er-hariprasadadhikari/Four-Switch-Synchronous-Buck-Boost-Converter/images/buck proteus 6 v.jpg

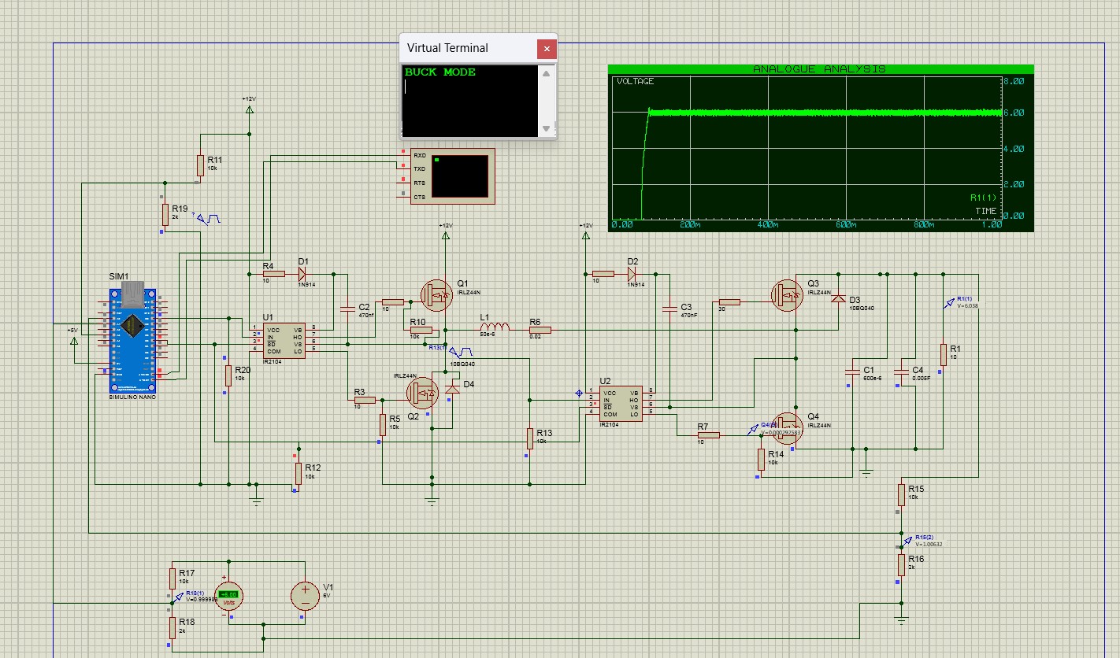
images/buck proteus 6 v.jpg
