er-hariprasadadhikari/Four-Switch-Synchronous-Buck-Boost-Converter/Hardware/final circuit.pdf

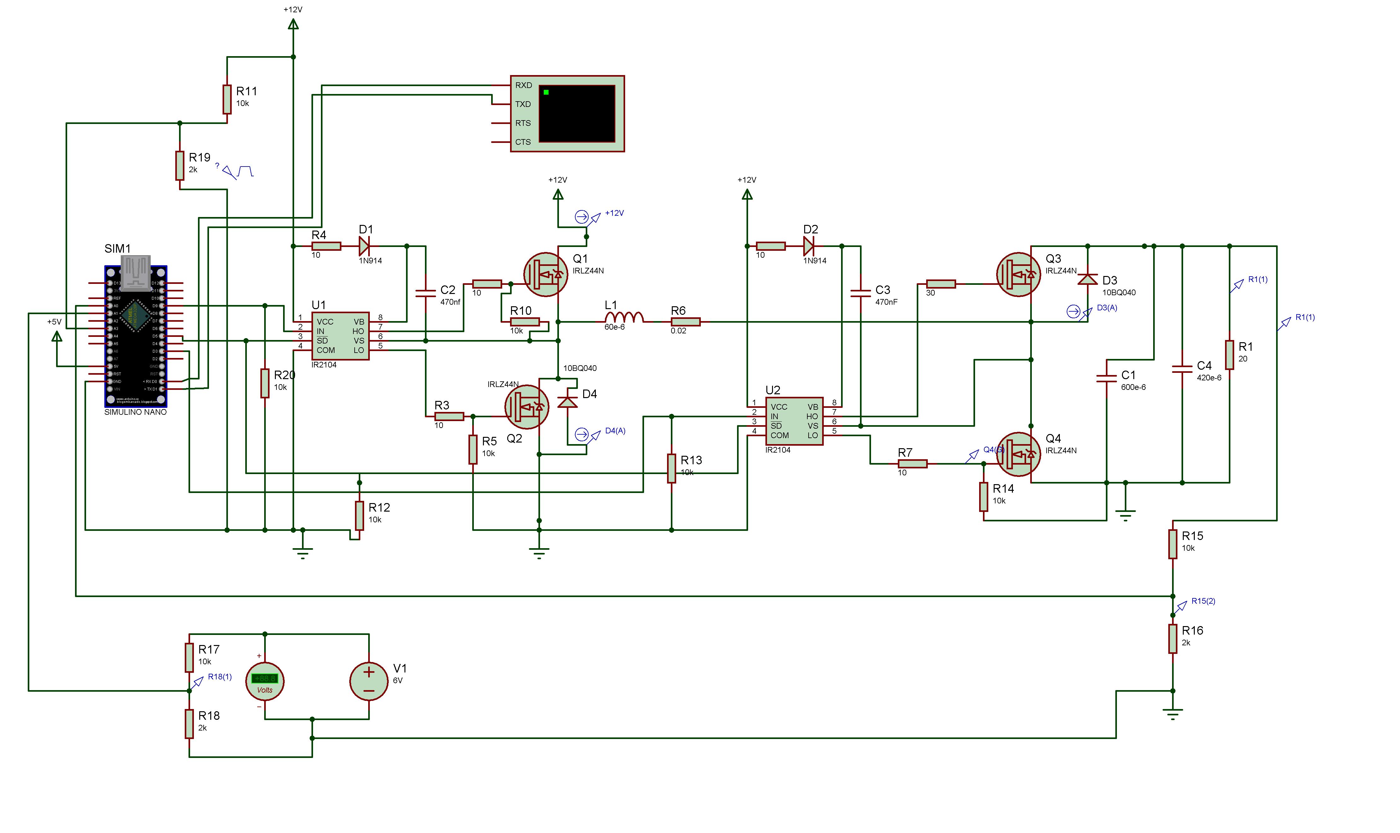
[picture p31: page 1]
