er-hariprasadadhikari/Four-Switch-Synchronous-Buck-Boost-Converter/images/boost with plot.jpg

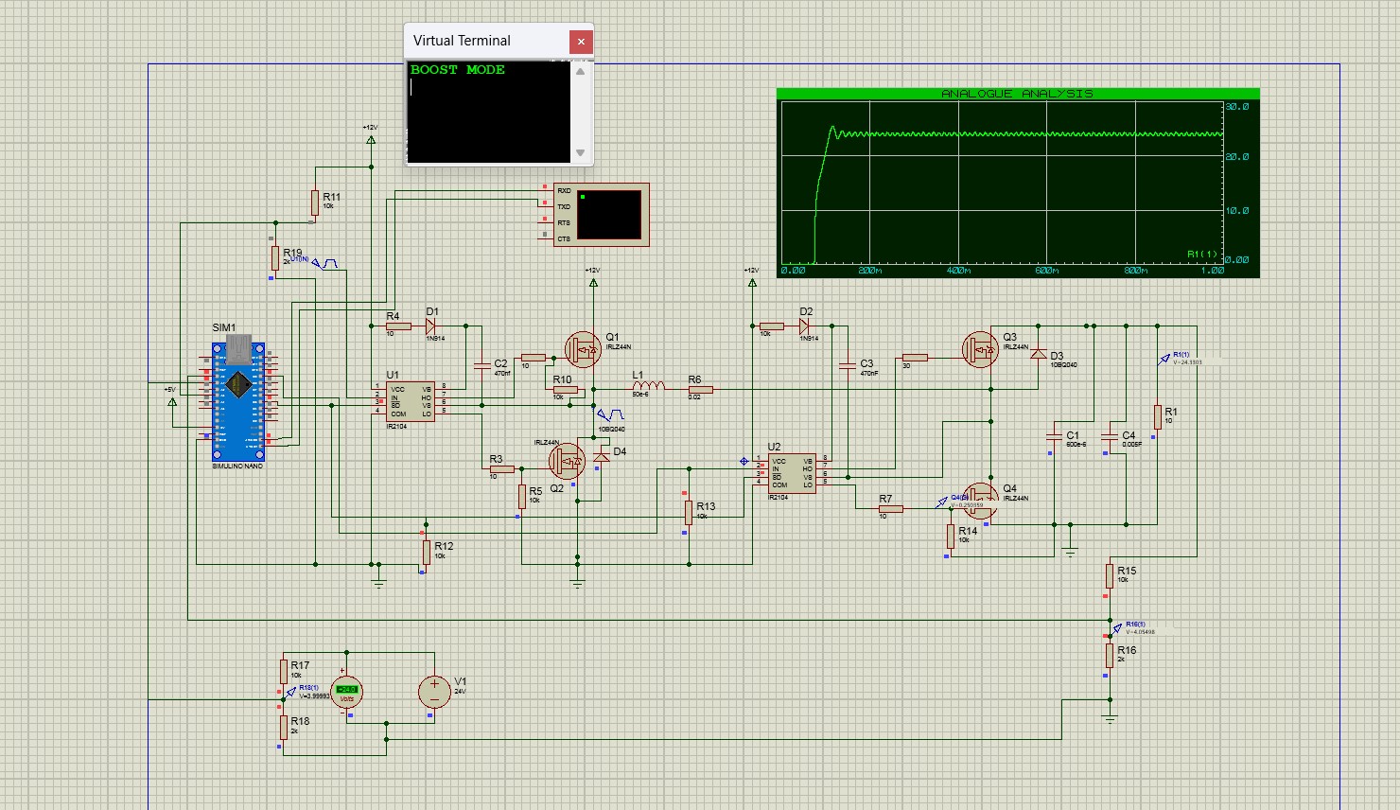
images/boost with plot.jpg
