er-hariprasadadhikari/Four-Switch-Synchronous-Buck-Boost-Converter/images/final block.jpg

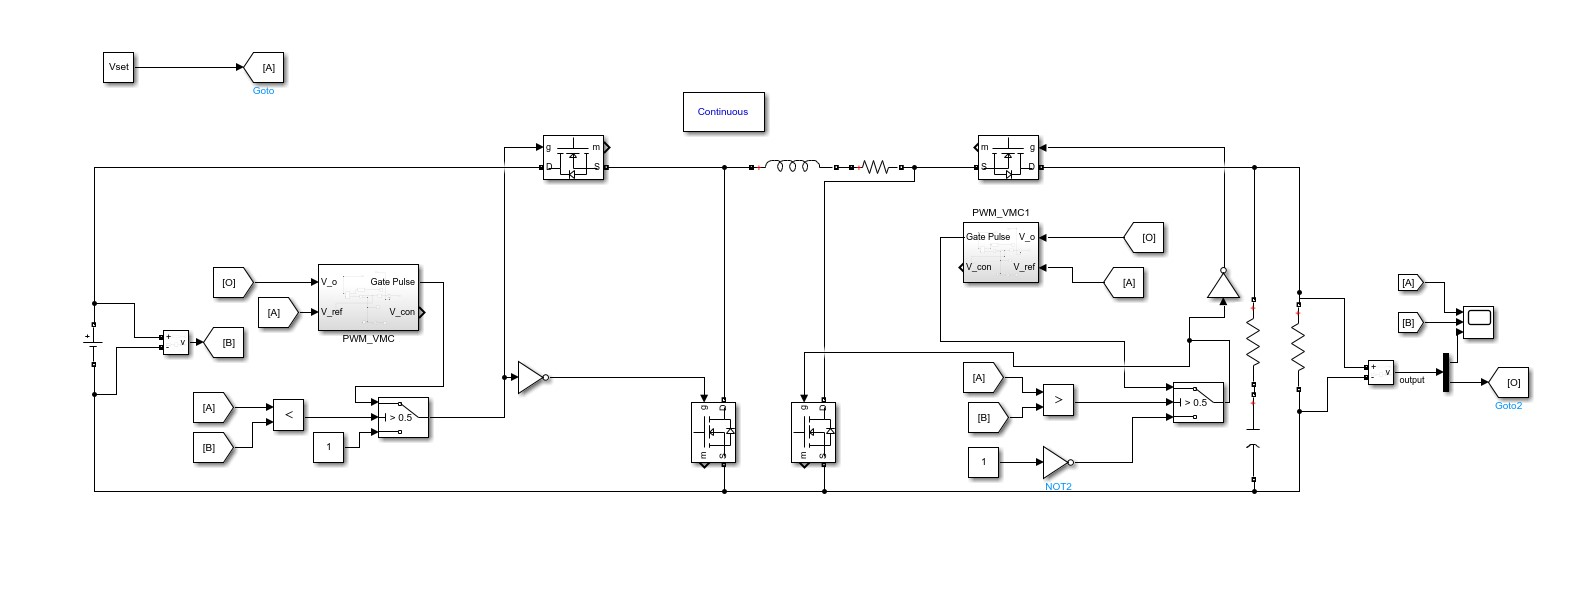
images/final block.jpg
