er-hariprasadadhikari/Four-Switch-Synchronous-Buck-Boost-Converter/images/four switch.jpg

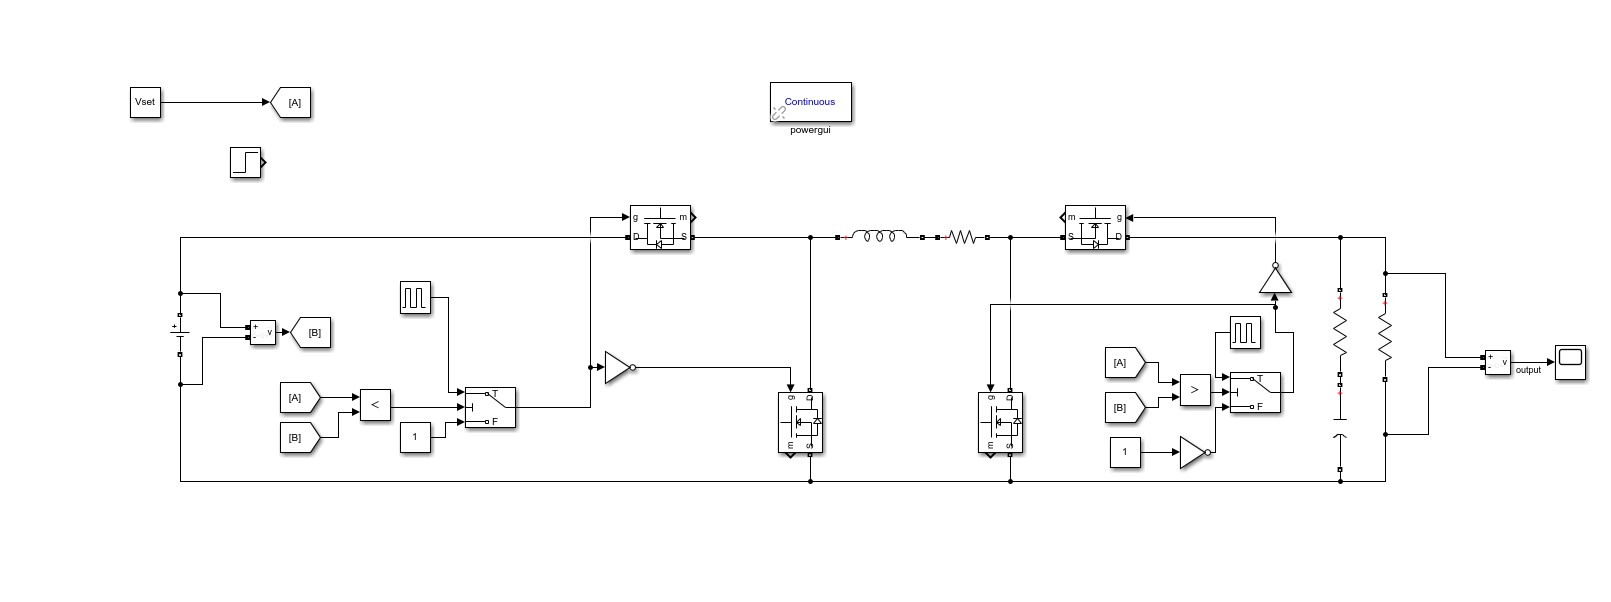
images/four switch.jpg
